pdgilbert/MCU-LoRa/README.md

# MCU-LoRa

Combine an MCU and LoRa radio onto a castellated PCB board.

##  Status: Prototype.

## Summary

Kicad project WIP.

The `.png` files are produced from kicad  in the `3D Viewer`  with `File > Export Current View as PNG`.






## History

 - Version 0.1.0 WIP circa 2025-09.
