pdgilbert/MCU-LoRa/ProjectNotes.txt

grep "/////////////// " ProjectNotes.txt   # for section index

////////////////////////////////////////////////////////////////////////////////
///////////////            To Do
////////////////////////////////////////////////////////////////////////////////

- Move mount hole away from antenna corner mother boards.

////////////////////////////////////////////////////////////////////////////////
///////////////     General Notes
////////////////////////////////////////////////////////////////////////////////
