pdgilbert/MCU-LoRa/SensorProject_QR.png

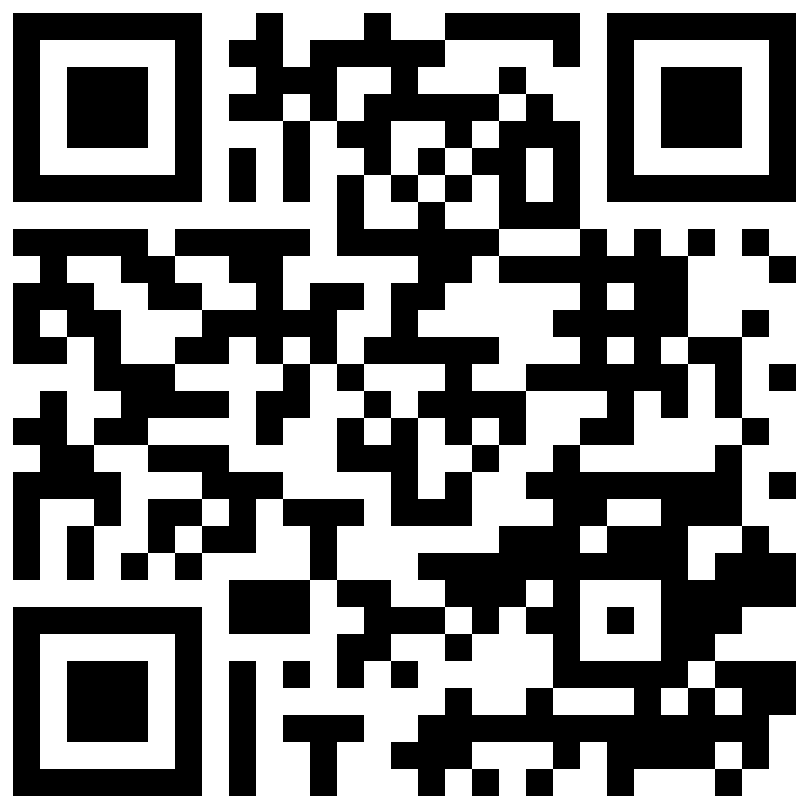
SensorProject_QR.png
