pdgilbert/MCU-LoRa/MCU-LoRa.kicad_pcb

## KiCad design MCU-LoRa.kicad_pcb (2025-11-27)

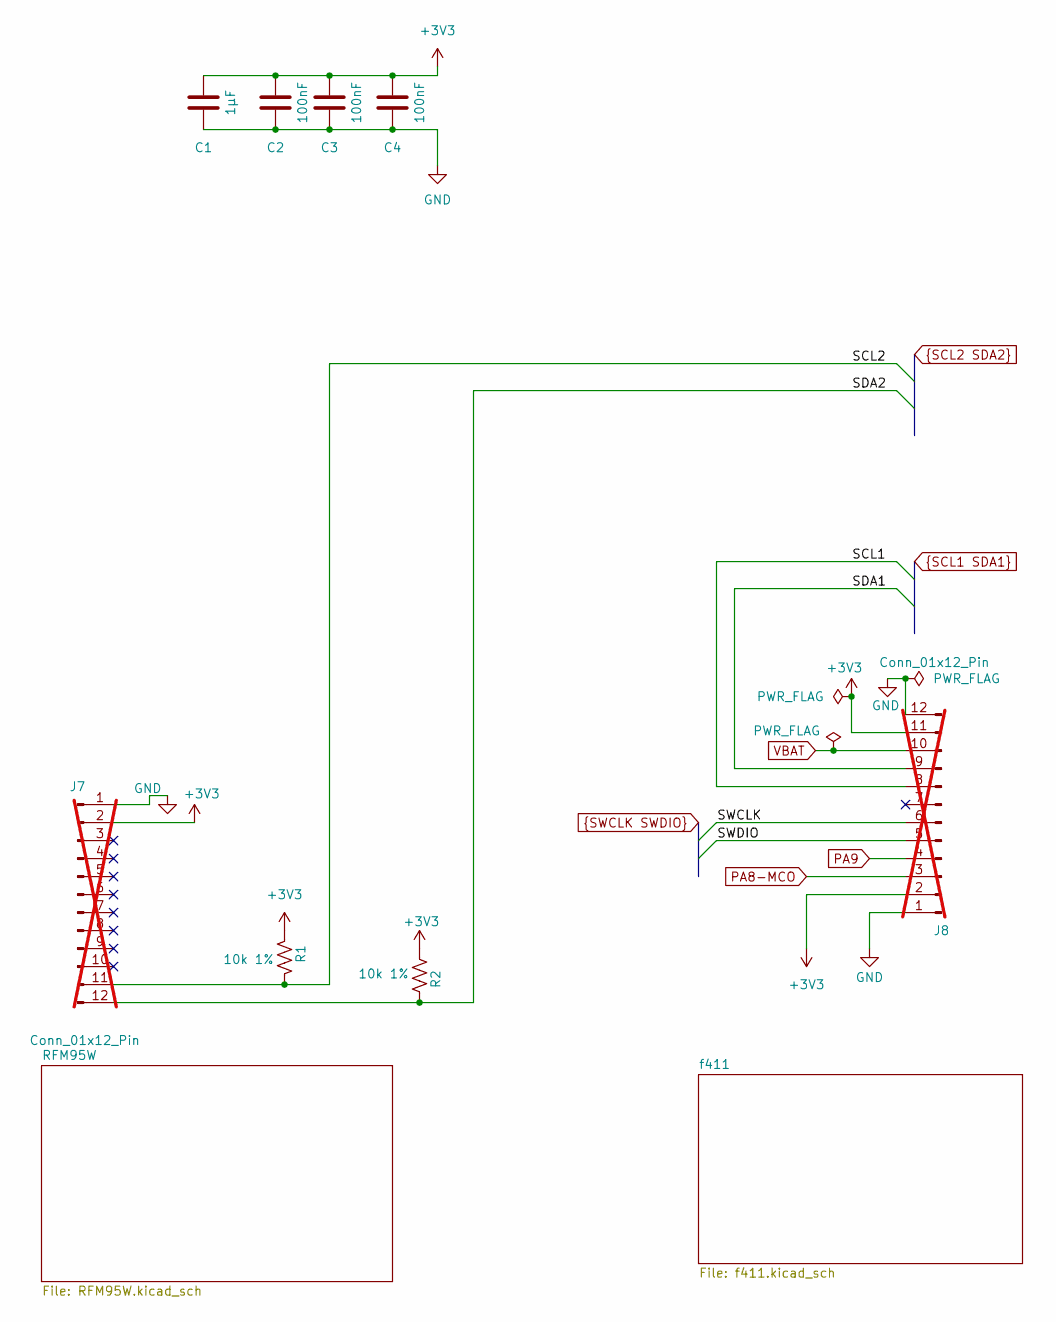
[picture p2: schematic MCU-LoRa.kicad_sch, F411-RFM95W]

Parts:
C1: 1µF; C_0402_1005Metric
C2, C3, C4: 100nF; C_0402_1005Metric
J7, J8: Conn_01x12_Pin; Castellated_Header_1x12_P2.00mm_Vertical; not fitted
R1, R2: 10k 1%; R_0402_1005Metric

Connections:
+3V3: C1.1, C2.1, C3.1, C4.1, J7.2, J8.2, J8.11, R1.1, R2.2; also elsewhere on the board
GND: C1.2, C2.2, C3.2, C4.2, J7.1, J8.1, J8.12; also elsewhere on the board
PA8-MCO: J8.3; also elsewhere on the board
PA9: J8.4; also elsewhere on the board
SCL1: J8.8; also elsewhere on the board
SCL2: J7.11, R1.2; also elsewhere on the board
SDA1: J8.9; also elsewhere on the board
SDA2: J7.12, R2.1; also elsewhere on the board
SWCLK: J8.6; also elsewhere on the board
SWDIO: J8.5; also elsewhere on the board
VBAT: J8.10; also elsewhere on the board

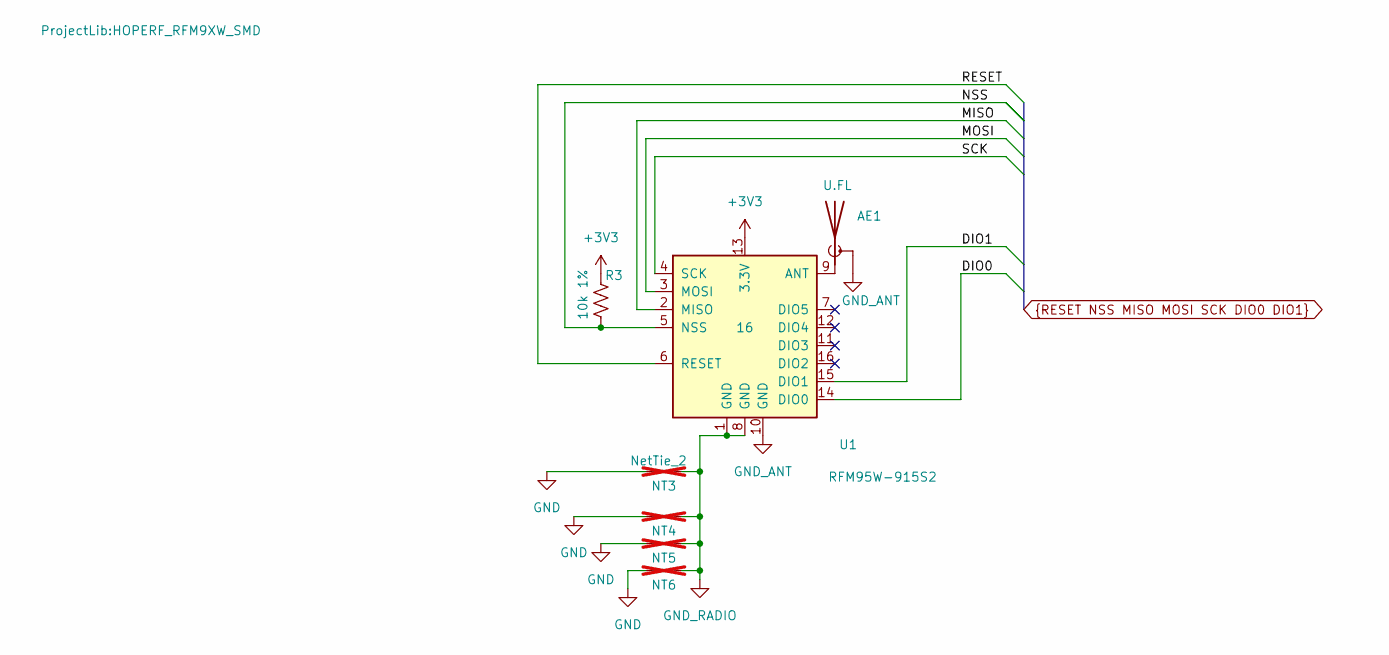
[picture p3: schematic RFM95W.kicad_sch, Multiplex I2C to Screw Terminal connectors]

Parts:
AE1: U.FL; U.FL_Molex_MCRF_73412-0110_Vertical; MfgPart U.FL-R-SMT-1
NT3, NT4, NT5, NT6: NetTie_2; NetTie-2_SMD_Pad0.5mm; not fitted
R3: 10k 1%; R_0402_1005Metric
U1: RFM95W-915S2; HOPERF_RFM9XW_SMD; MfgPart RFM95W-915S2

Connections:
+3V3: R3.1, U1.13 (3.3V); also elsewhere on the board
DIO0: U1.14 (DIO0); also elsewhere on the board
DIO1: U1.15 (DIO1); also elsewhere on the board
GND: NT3.1, NT4.1, NT5.1, NT6.1; also elsewhere on the board
GND_ANT: AE1.2 (Shield), U1.10 (GND)
GND_RADIO: NT3.2, NT4.2, NT5.2, NT6.2, U1.1 (GND), U1.8 (GND)
MISO: U1.2 (MISO); also elsewhere on the board
MOSI: U1.3 (MOSI); also elsewhere on the board
NSS: R3.2, U1.5 (NSS); also elsewhere on the board
unnamed: AE1.1 (A), U1.9 (ANT)
RESET: U1.6 (RESET); also elsewhere on the board
SCK: U1.4 (SCK); also elsewhere on the board

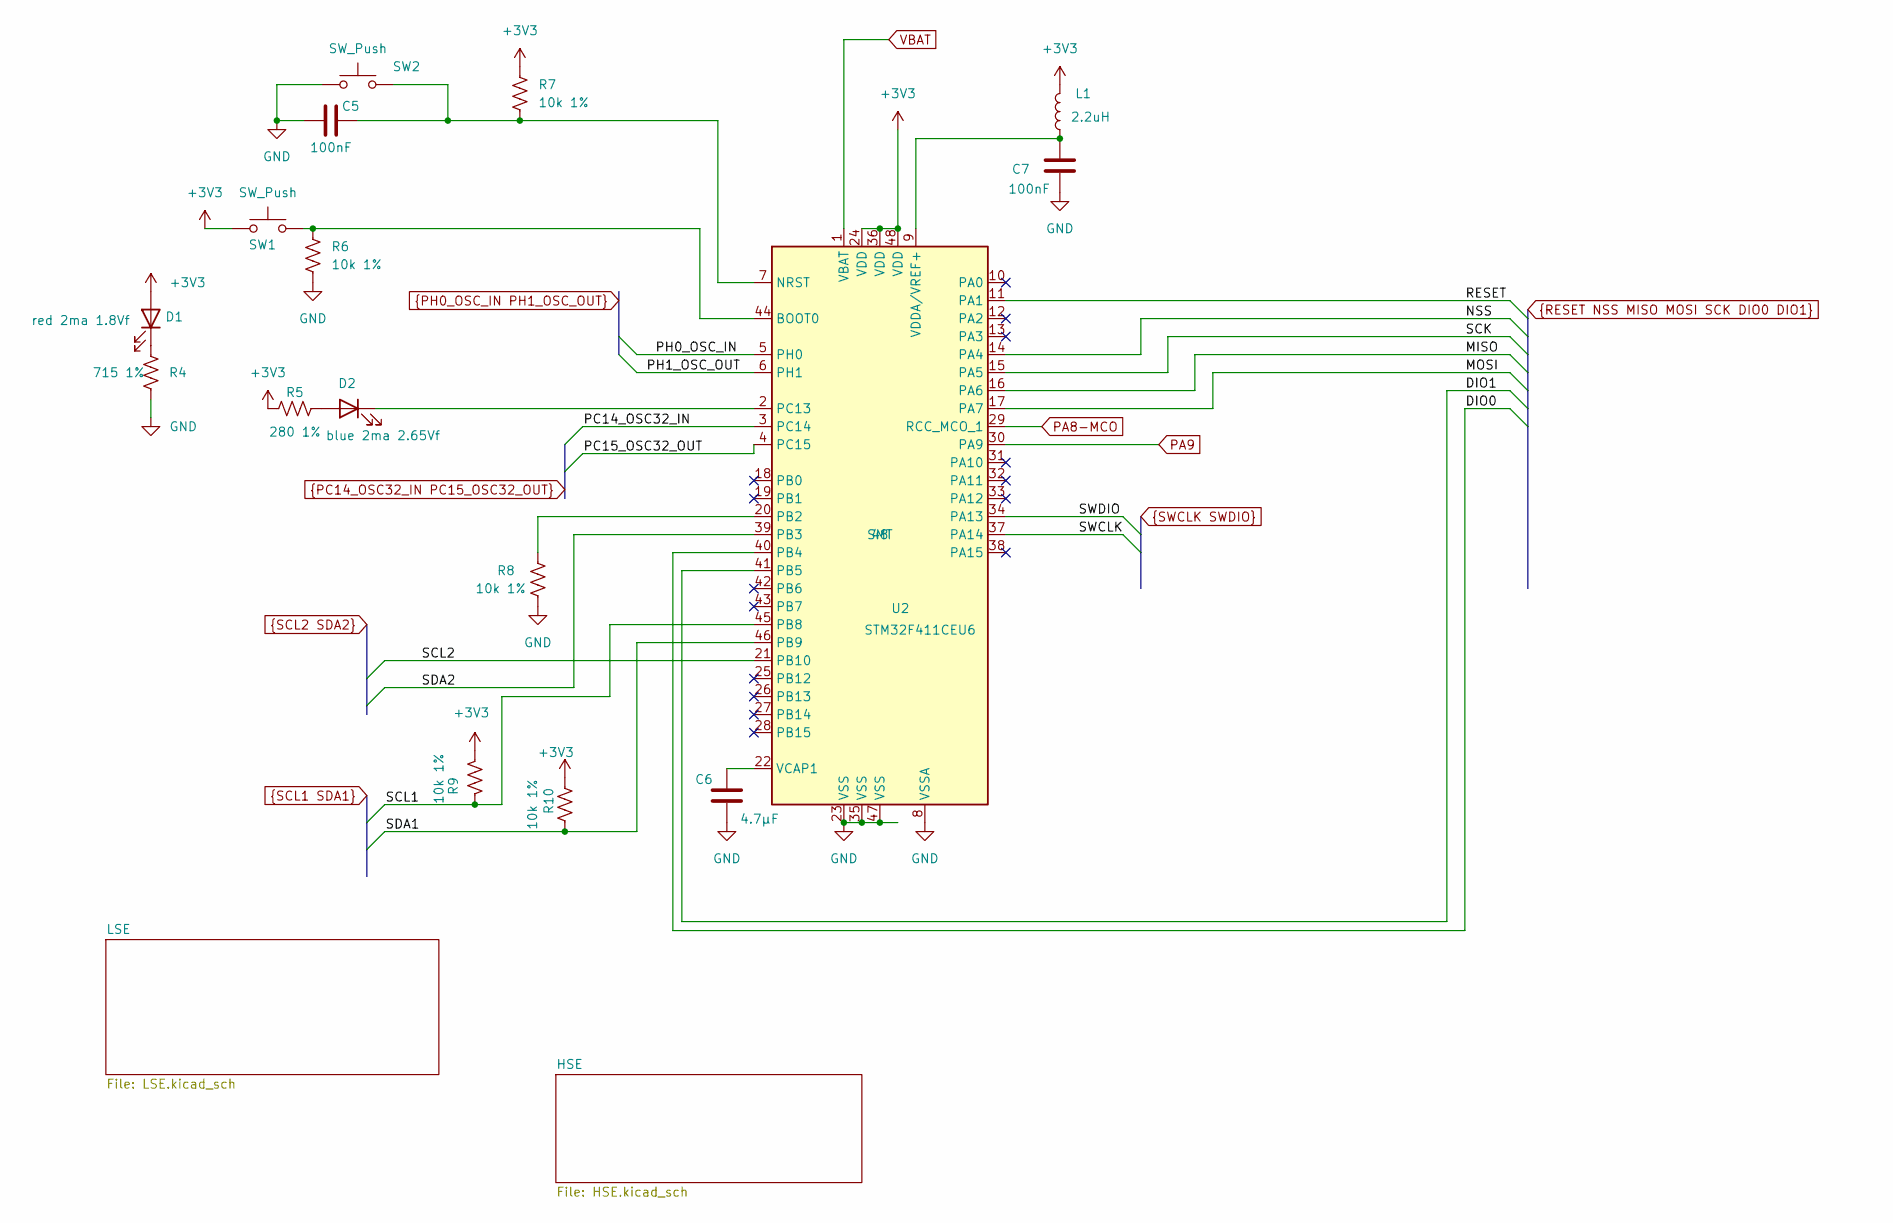
[picture p4: schematic f411.kicad_sch, F411-RFM95W]

Parts:
C5, C7: 100nF; C_0402_1005Metric
C6: 4.7µF; C_0402_1005Metric
D1: red 2ma 1.8Vf; LED_0603_1608Metric; MfgPart APT1608LSECK/J3-PRV
D2: blue 2ma 2.65Vf; LED_0603_1608Metric; MfgPart APT1608LVBC/D
L1: 2.2uH; L_0402_1005Metric; MfgPart MLZ1005M2R2WT000
R4: 715 1%; R_0402_1005Metric
R5: 280 1%; R_0402_1005Metric
R6, R7, R8, R9, R10: 10k 1%; R_0402_1005Metric
SW1, SW2: SW_Push; SW_SPST_B3U-1000P; MfgPart B3U-1000P
U2: STM32F411CEU6; QFN-48-1EP_7x7mm_P0.5mm_EP5.6x5.6mm; MfgPart STM32F411CEU6

Connections:
+3V3: D1.2 (A), L1.2, R5.1, R7.1, R9.1, R10.1, SW1.1, U2.24 (VDD), U2.36 (VDD), U2.48 (VDD); also elsewhere on the board
DIO0: U2.40 (PB4); also elsewhere on the board
DIO1: U2.41 (PB5); also elsewhere on the board
GND: C5.1, C6.2, C7.2, R4.2, R6.2, R8.2, SW2.1, U2.8 (VSSA), U2.23 (VSS), U2.35 (VSS), U2.47 (VSS), U2.49 (VSS); also elsewhere on the board
MISO: U2.16 (PA6); also elsewhere on the board
MOSI: U2.17 (PA7); also elsewhere on the board
NSS: U2.14 (PA4); also elsewhere on the board
unnamed: D1.1 (K), R4.1
unnamed: D2.2 (A), R5.2
unnamed: D2.1 (K), U2.2 (PC13)
unnamed: R6.1, SW1.2, U2.44 (BOOT0)
unnamed: C5.2, R7.2, SW2.2, U2.7 (NRST)
unnamed: R8.1, U2.20 (PB2)
unnamed: C6.1, U2.22 (VCAP1)
unnamed: C7.1, L1.1, U2.9 (VDDA/VREF+)
PA8-MCO: U2.29 (RCC_MCO_1); also elsewhere on the board
PA9: U2.30 (PA9); also elsewhere on the board
PC14_OSC32_IN: U2.3 (PC14); also elsewhere on the board
PC15_OSC32_OUT: U2.4 (PC15); also elsewhere on the board
PH0_OSC_IN: U2.5 (PH0); also elsewhere on the board
PH1_OSC_OUT: U2.6 (PH1); also elsewhere on the board
RESET: U2.11 (PA1); also elsewhere on the board
SCK: U2.15 (PA5); also elsewhere on the board
SCL1: R9.2, U2.45 (PB8); also elsewhere on the board
SCL2: U2.21 (PB10); also elsewhere on the board
SDA1: R10.2, U2.46 (PB9); also elsewhere on the board
SDA2: U2.39 (PB3); also elsewhere on the board
SWCLK: U2.37 (PA14); also elsewhere on the board
SWDIO: U2.34 (PA13); also elsewhere on the board
VBAT: U2.1 (VBAT); also elsewhere on the board

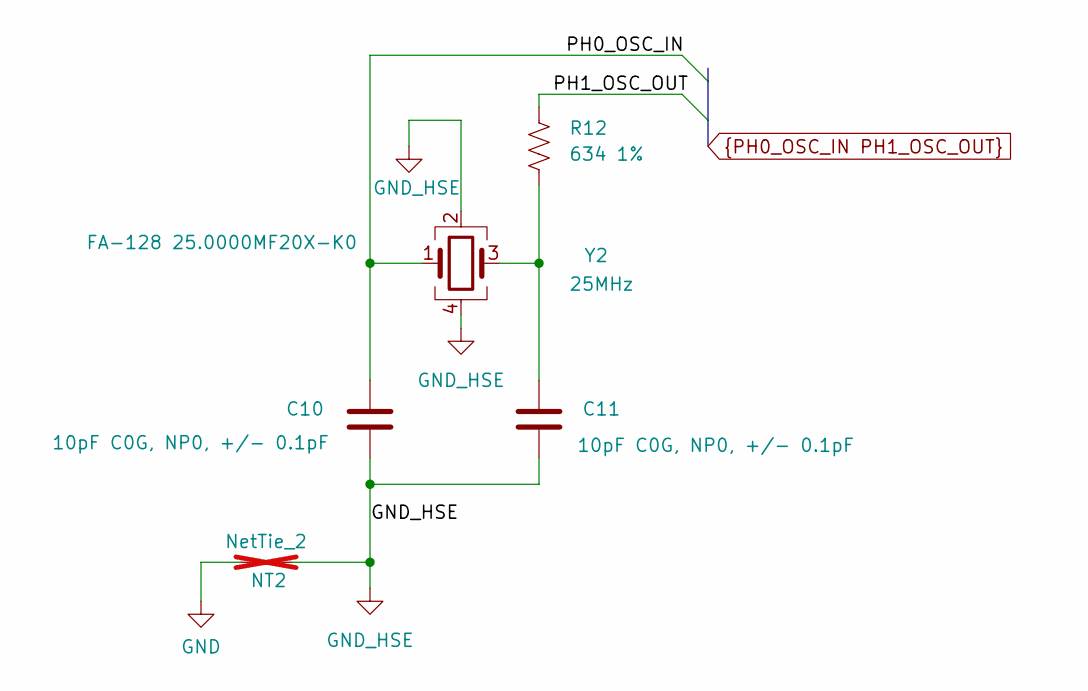
[picture p5: schematic HSE.kicad_sch, F411-RFM95W]

Parts:
C10, C11: 10pF C0G, NP0, +/- 0.1pF; C_0402_1005Metric
NT2: NetTie_2; NetTie-2_SMD_Pad0.5mm; not fitted
R12: 634 1%; R_0402_1005Metric
Y2: 25MHz; Crystal_SMD_2016-4Pin_2.0x1.6mm; MfgPart FA-128 25.0000MF20X-K0

Connections:
GND: NT2.1; also elsewhere on the board
GND_HSE: C10.1, C11.1, NT2.2, Y2.2, Y2.4
unnamed: C11.2, R12.2, Y2.3
PH0_OSC_IN: C10.2, Y2.1; also elsewhere on the board
PH1_OSC_OUT: R12.1; also elsewhere on the board

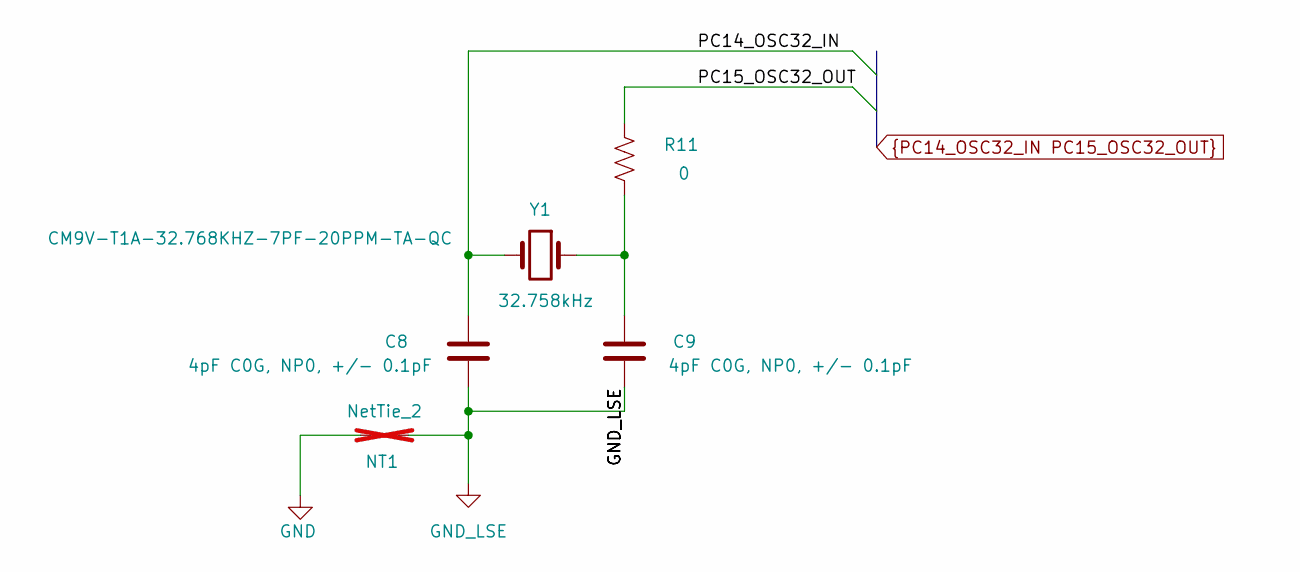
[picture p6: schematic LSE.kicad_sch, F411-RFM95W]

Parts:
C8, C9: 4pF C0G, NP0, +/- 0.1pF; C_0402_1005Metric
NT1: NetTie_2; NetTie-2_SMD_Pad0.5mm; not fitted
R11: 0; R_0402_1005Metric
Y1: 32.758kHz; Crystal_SMD_MicroCrystal_CM9V-T1A-2Pin_1.6x1.0mm; MfgPart CM9V-T1A-32.768KHZ-7PF-20PPM-TA-QC

Connections:
GND: NT1.1; also elsewhere on the board
GND_LSE: C8.1, C9.1, NT1.2
unnamed: C9.2, R11.2, Y1.1
PC14_OSC32_IN: C8.2, Y1.2; also elsewhere on the board
PC15_OSC32_OUT: R11.1; also elsewhere on the board

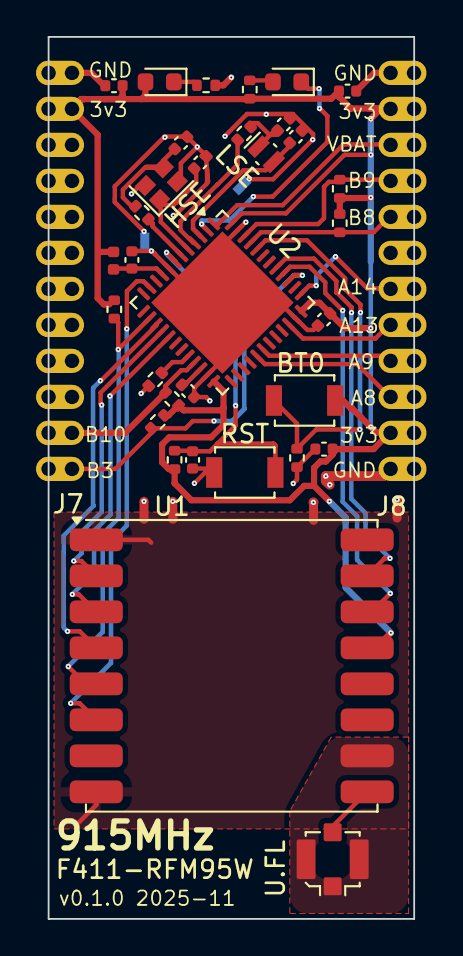
[picture p7: board MCU-LoRa.kicad_pcb from above]

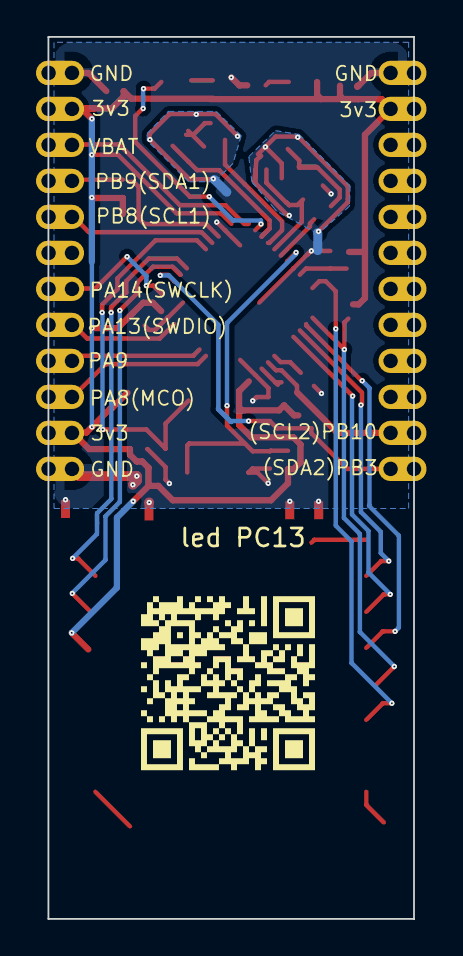
[picture p8: board MCU-LoRa.kicad_pcb from below]

Board: 2 copper layers, 20.3 x 49.0 mm, 41 parts (2 on the bottom side), 37 nets.
