pdgilbert/MCU-LoRa/(commit log)

2025-09-12 initial commit. F411-RFM95W ERC good. DRC has lots of warnings and much cleanup needed.
    [HSE.kicad_sch, LSE.kicad_sch, MCU-LoRa.kicad_pcb, MCU-LoRa.kicad_sch, RFM95W.kicad_sch, f411.kicad_sch]
2025-09-12 changed from vias to microvias. ERC ok. DRC has only warnings related to castellated edges cutting footprints.
    [MCU-LoRa.kicad_pcb]
2025-09-17 3v3 trace moved to back side.
    [MCU-LoRa.kicad_pcb, MCU-LoRa.kicad_sch, f411.kicad_sch]
2025-09-17 move antenna U.FL closer to corner.
    [MCU-LoRa.kicad_pcb]
2025-09-27 MCU moved down closer to radio. Connectors need better arrangement.
    [MCU-LoRa.kicad_pcb, f411.kicad_sch]
2025-09-30 ongoing cleanup. DRC clean excluding edge cut of castellated holes.
    [MCU-LoRa.kicad_pcb, MCU-LoRa.kicad_sch]
2025-11-10 reduced with of board.
    [MCU-LoRa.kicad_pcb, f411.kicad_sch]
2025-11-11 added QR code
    [MCU-LoRa.kicad_pcb]
2025-11-17 settled on 24-pins. Fairly clean castillated pin header but no footprint yet. Decided against rotating radio.
    [MCU-LoRa.kicad_pcb, MCU-LoRa.kicad_sch, f411.kicad_sch]
2025-11-18 cleanup. ERC and DRC good. No footprint yet.
    [MCU-LoRa.kicad_pcb, MCU-LoRa.kicad_sch, RFM95W.kicad_sch]
2025-11-27 added footprint and step model. Cleaned up silkscreen and fab layers.
    [HSE.kicad_sch, LSE.kicad_sch, MCU-LoRa.kicad_pcb, MCU-LoRa.kicad_sch, RFM95W.kicad_sch, f411.kicad_sch]
